Greg-R/qse2/README.md

QSE2DCEZ Transmitter Module

The documentation for this design is located here:
<https://kf5n.com/t41-2/qse2dcez/>
