Greg-R/qse2/doc/qse2.pdf

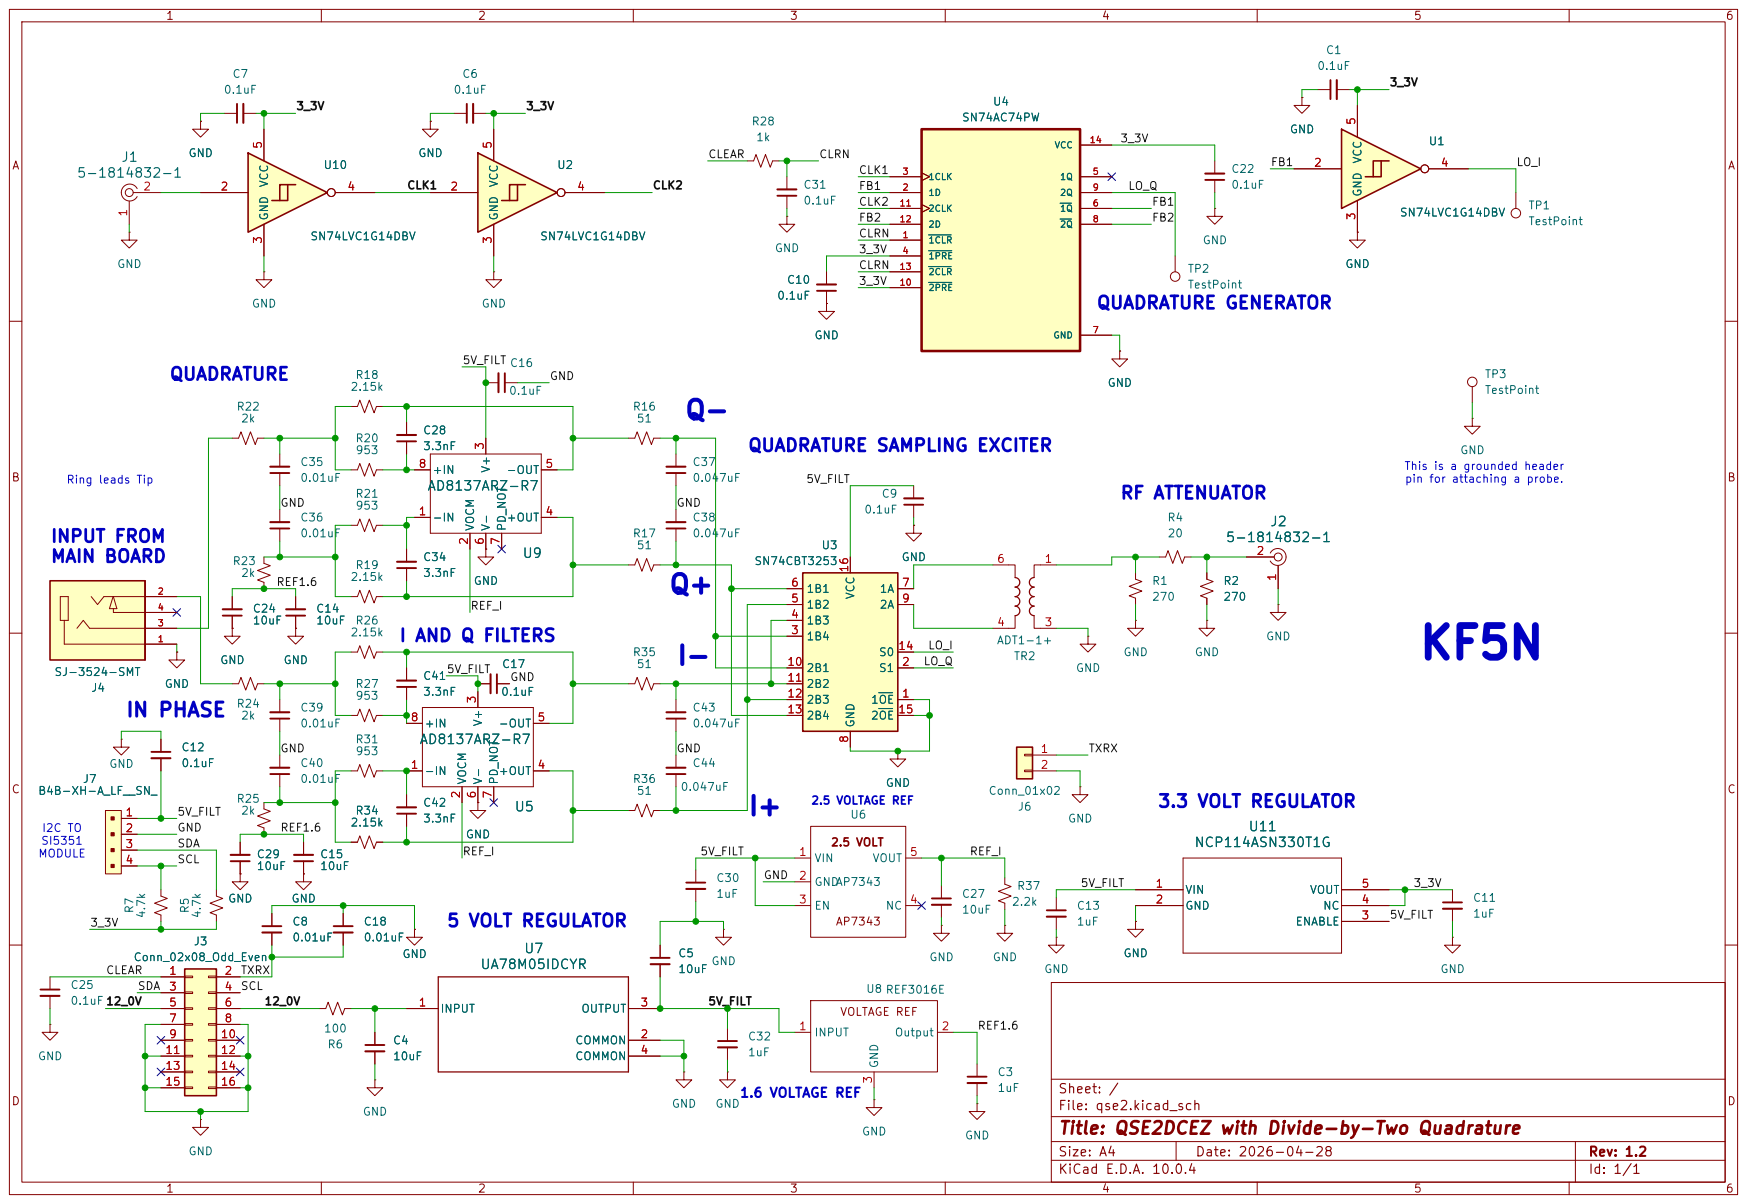
[picture p1: page 1]

This is a grounded header pin for attaching a probe.

2B1 10
2B2 11

Sheet: /
File: qse2.kicad_sch
Title: QSE2DCEZ with Divide-by-Two Quadrature

Size: A4 | Rev: 1.2
KiCad E.D.A. 10.0.4 | Id: 1/1
