Greg-R/qse2/qse2.kicad_pcb

## KiCad design qse2.kicad_pcb (2026-07-23)

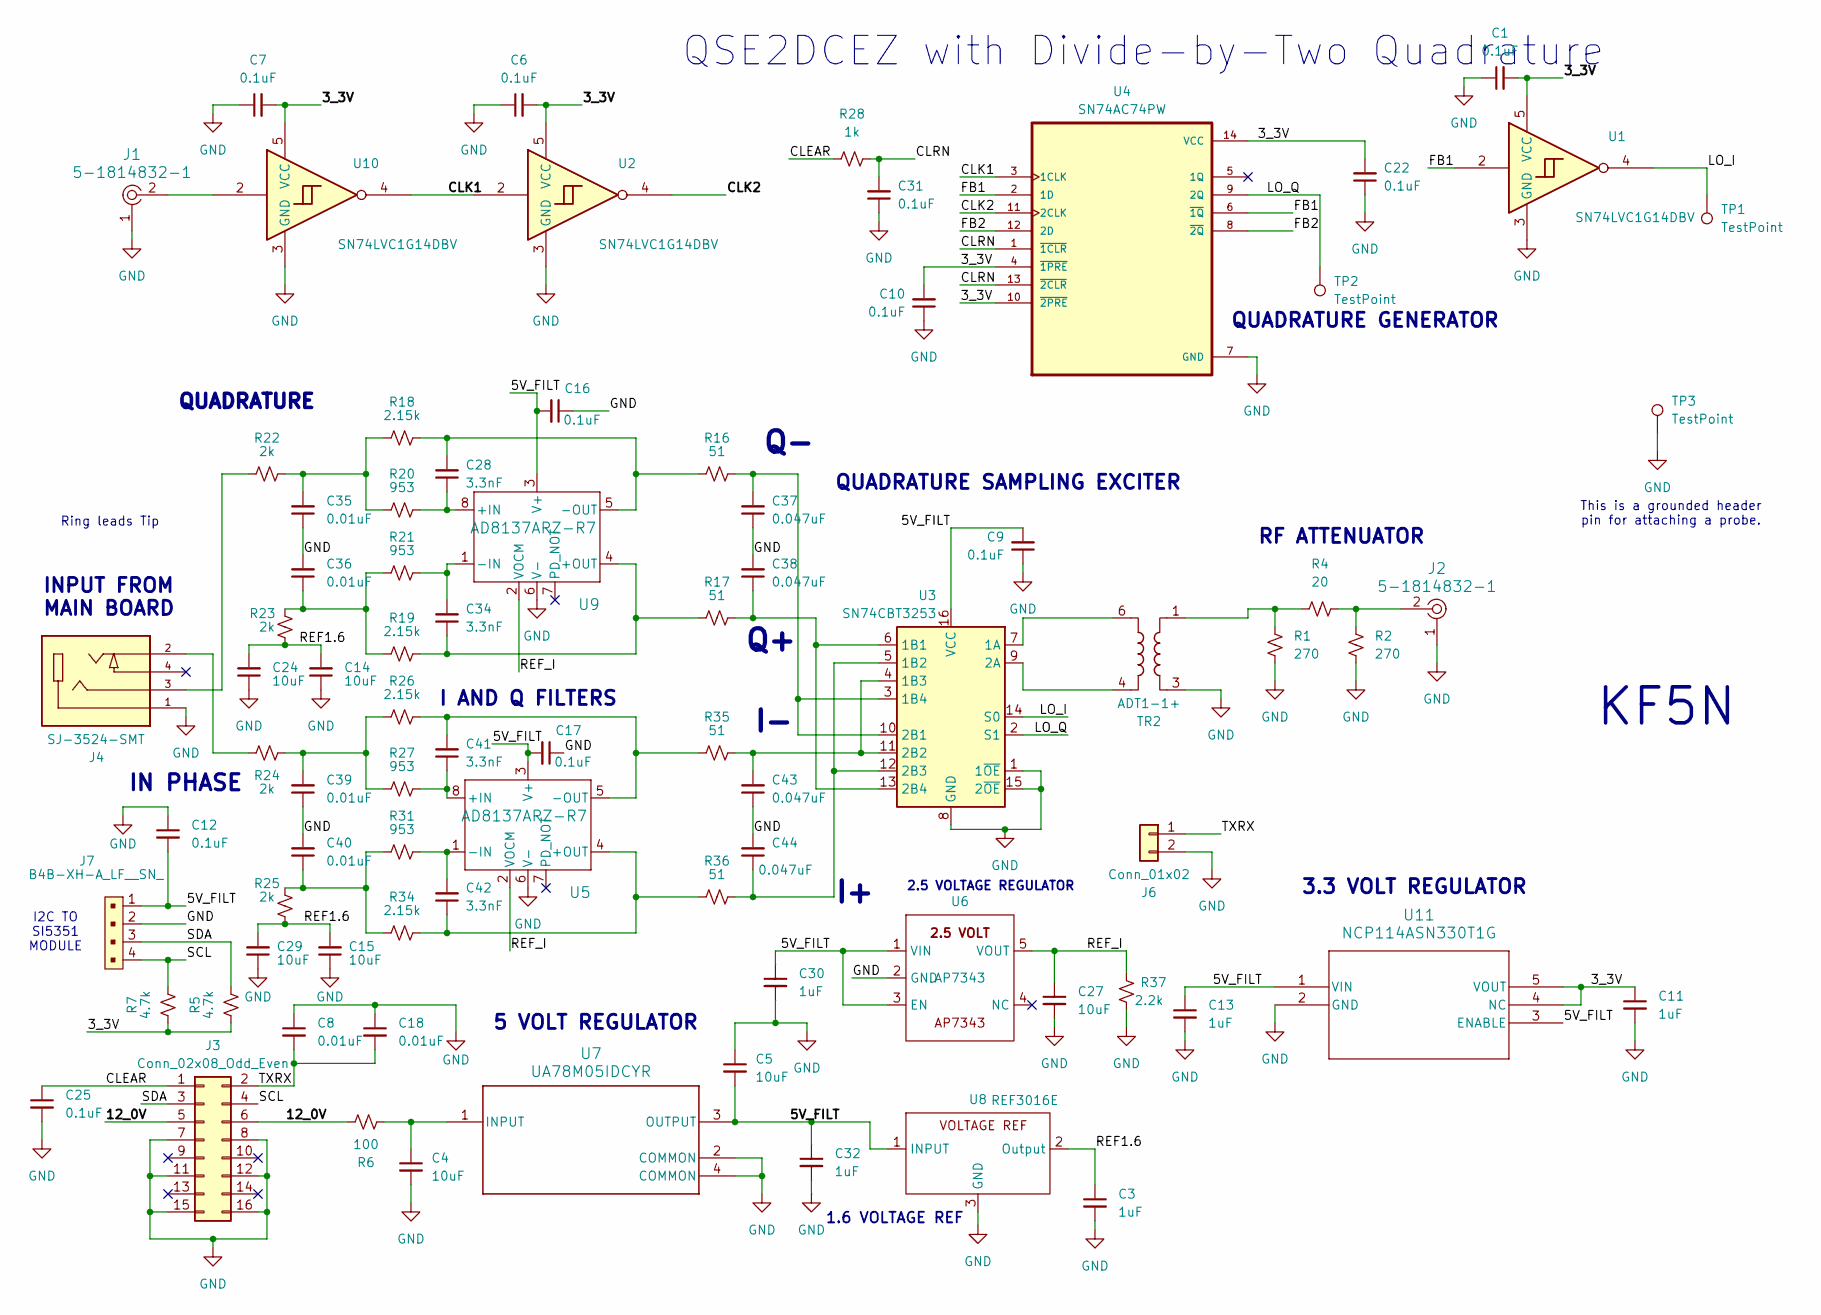
[picture p2: schematic qse2.kicad_sch, QSE2DCEZ with Divide-by-Two Quadrature]

Parts:
C1, C6, C7, C9, C10, C12, C16, C17, C22, C25, C31: 0.1uF; C_1206_3216Metric
C3, C11, C13, C30, C32: 1uF; C_1206_3216Metric
C4, C5, C14, C15, C24, C27, C29: 10uF; C_1206_3216Metric
C8, C18, C35, C36, C39, C40: 0.01uF; C_1206_3216Metric
C28, C34, C41, C42: 3.3nF; C_1206_3216Metric
C37, C38, C43, C44: 0.047uF; C_1206_3216Metric
J1, J2: 5-1814832-1; RF_SMA_Vertical_5-1814832-1; MPN 5-1814832-1; Digi-Key_PN A97594-ND
J3: Conn_02x08_Odd_Even; IDC-Header_2x08_P2.54mm_Vertical
J4: SJ-3524-SMT; CUI_SJ-3524-SMT; PARTREV 1.03
J6: Conn_01x02; PinHeader_1x2_P2.5mm_Drill1.1mm
J7: B4B-XH-A_LF__SN_; PinHeader_1x4_P2.5mm_Drill1.1mm; MPN B4B-XH-A(LF)(SN); Digi-Key_PN 455-2249-ND
R1, R2: 270; R_1206_3216Metric
R4: 20; R_1206_3216Metric
R5, R7: 4.7k; R_1206_3216Metric
R6: 100; R_1206_3216Metric
R16, R17, R35, R36: 51; R_1206_3216Metric
R18, R19, R26, R34: 2.15k; R_1206_3216Metric
R20, R21, R27, R31: 953; R_1206_3216Metric
R22, R23, R24, R25: 2k; R_1206_3216Metric
R28: 1k; R_1206_3216Metric
R37: 2.2k; R_1206_3216Metric
TP1, TP2: TestPoint; TestPoint_Pad_D1.0mm
TP3: TestPoint; PinHeader_1x01_P2.54mm_Vertical
TR2: ADT1-1+; Mini-Circuits_CD542_H2.84mm
U1, U2, U10: SN74LVC1G14DBV; SOT-23-5
U3: SN74CBT3253; SOIC-16_3.9x9.9mm_P1.27mm
U4: SN74AC74PW; SOIC-14_3.9x8.7mm_P1.27mm
U5, U9: AD8137ARZ-R7; R_8_ADI
U6: AP7343; TSOT-23-5
U7: UA78M05IDCYR; DCY0004A_N
U8: REF3016E; SOT-23-3
U11: NCP114ASN330T1G; TSOP-5-483-N_ONS

Connections:
/3_3V: C1.2, C6.2, C7.2, C10.2, C11.1, C22.2, R5.1, R7.1, U1.5 (VCC), U2.5 (VCC), U4.4 (~1PRE), U4.10 (~2PRE), U4.14 (VCC), U10.5 (VCC), U11.4 (NC), U11.5 (VOUT)
/5V_FILT: C5.2, C9.2, C12.2, C13.1, C16.2, C17.2, C30.1, C32.1, J7.1, U3.16 (VCC), U5.3 (V+), U6.1 (VIN), U6.3 (EN), U7.3 (OUTPUT), U8.1 (INPUT), U9.3 (V+), U11.1 (VIN), U11.3 (ENABLE)
/12_0V: J3.5, J3.6, R6.1
/CLEAR: C25.1, J3.1, R28.1
/CLK1: U2.2, U4.3 (1CLK), U10.4
/CLK2: U2.4, U4.11 (2CLK)
/CLRN: C31.2, R28.2, U4.1 (~1CLR), U4.13 (~2CLR)
/FB1: U1.2, U4.2 (1D), U4.6 (~1Q)
/FB2: U4.8 (~2Q), U4.12 (2D)
/LO_I: TP1.1 (1_1), U1.4, U3.14 (S0)
/LO_Q: TP2.1 (1_1), U3.2 (S1), U4.9 (2Q)
/REF1.6: C3.1, C14.2, C15.2, C24.2, C29.2, R23.1, R25.1, U8.2 (Output)
/REF_I: C27.1, R37.2, U5.2 (VOCM), U6.5 (VOUT), U9.2 (VOCM)
/SCL: J3.4, J7.4, R7.2
/SDA: J3.3, J7.3, R5.2
/TXRX: C8.2, C18.2, J3.2, J6.1
GND: C1.1, C3.2, C4.2, C5.1, C6.1, C7.1, C8.1, C9.1, C10.1, C11.2, C12.1, C13.2, C14.1, C15.1, C16.1, C17.1, C18.1, C22.1, C24.1, C25.2, C27.2, C29.1, C30.2, C31.1, C32.2, C35.1, C36.2, C37.1, C38.2, C39.1, C40.2, C43.1, C44.2, J1.1, J2.1, J3.7, J3.8, J3.11, J3.12, J3.15, J3.16, J4.1, J6.2, J7.2, R1.2, R2.2, R37.1, TP3.1 (1_1), TR2.3, U1.3 (GND), U2.3 (GND), U3.1 (1~OE), U3.8 (GND), U3.15 (2~OE), U4.7 (GND), U5.6 (V-), U6.2 (GND), U7.2 (COMMON), U7.4 (COMMON), U8.3 (GND), U9.6 (V-), U10.3 (GND), U11.2 (GND)
unnamed: C35.2, R18.1, R20.1, R22.2
unnamed: C36.1, R19.1, R21.1, R23.2
unnamed: C39.2, R24.2, R26.1, R27.1
unnamed: C40.1, R25.2, R31.1, R34.1
unnamed: J1.2, U10.2
unnamed: J2.2, R2.1, R4.2
unnamed: J4.2, R24.1
unnamed: J4.3, R22.1
unnamed: R1.1, R4.1, TR2.1
unnamed: TR2.6, U3.7 (1A)
unnamed: C38.1, R17.2, U3.6 (1B1), U3.13 (2B4)
unnamed: C44.1, R36.2, U3.5 (1B2), U3.12 (2B3)
unnamed: C43.2, R35.2, U3.4 (1B3), U3.11 (2B2)
unnamed: C37.2, R16.2, U3.3 (1B4), U3.10 (2B1)
unnamed: TR2.4, U3.9 (2A)
unnamed: C41.1, R27.2, U5.8 (+IN)
unnamed: C42.1, R34.2, R36.1, U5.4 (+OUT)
unnamed: C42.2, R31.2, U5.1 (-IN)
unnamed: C41.2, R26.2, R35.1, U5.5 (-OUT)
unnamed: C4.1, R6.2, U7.1 (INPUT)
unnamed: C28.1, R20.2, U9.8 (+IN)
unnamed: C34.1, R17.1, R19.2, U9.4 (+OUT)
unnamed: C34.2, R21.2, U9.1 (-IN)
unnamed: C28.2, R16.1, R18.2, U9.5 (-OUT)

Notes on the sheet:
Ring leads Tip
3.3 VOLT REGULATOR
KF5N
QUADRATURE
IN PHASE
QUADRATURE SAMPLING EXCITER
QUADRATURE GENERATOR
1.6 VOLTAGE REF
RF ATTENUATOR
I2C TO SI5351 MODULE
INPUT FROM MAIN BOARD
This is a grounded header pin for attaching a probe.
I AND Q FILTERS
5 VOLT REGULATOR
QSE2DCEZ with Divide-by-Two Quadrature
2.5 VOLTAGE REGULATOR

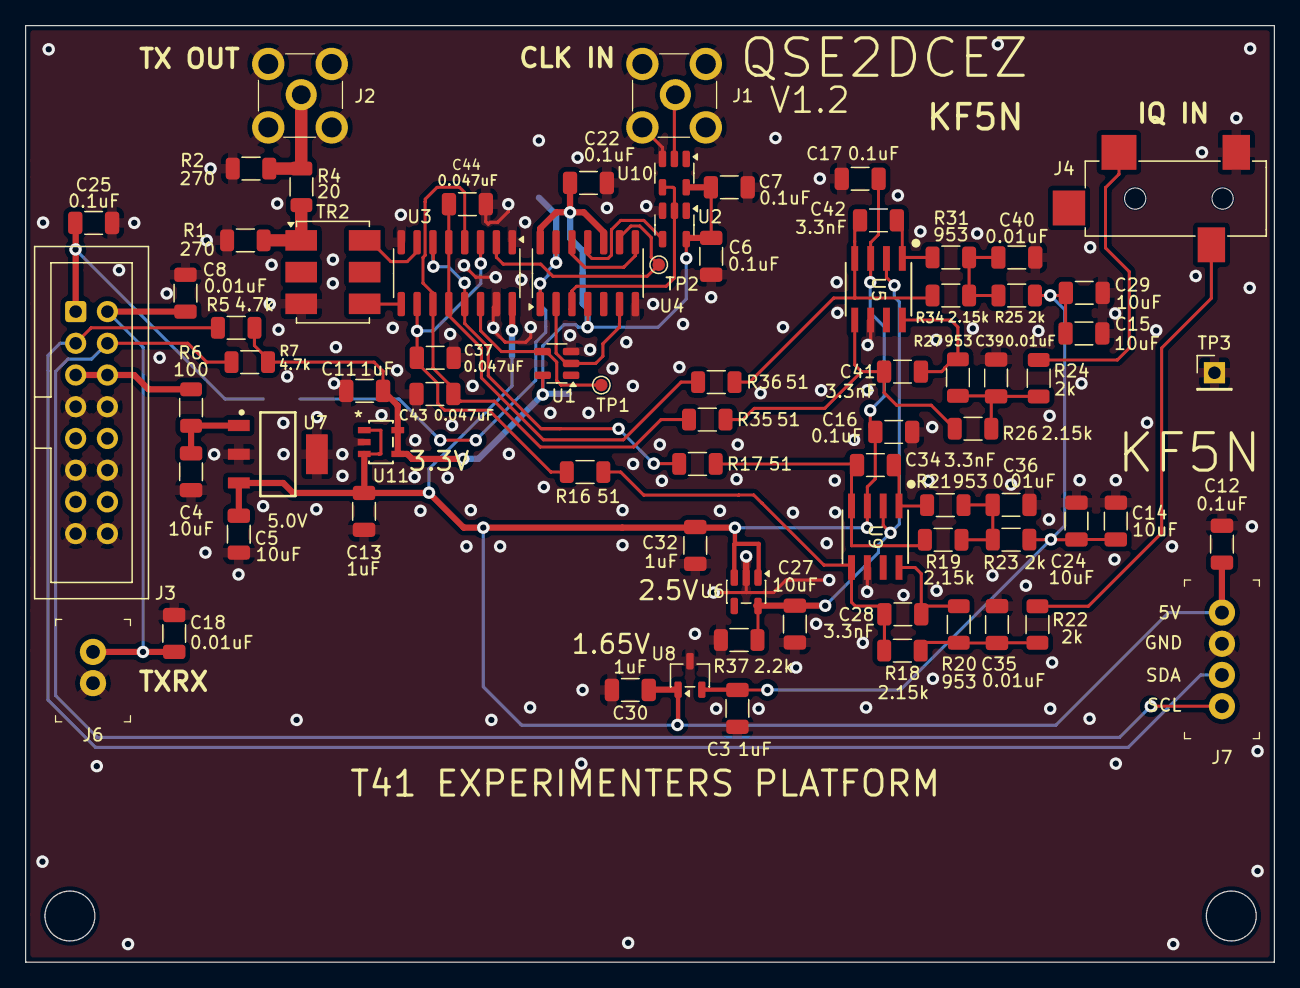
[picture p3: board qse2.kicad_pcb from above]

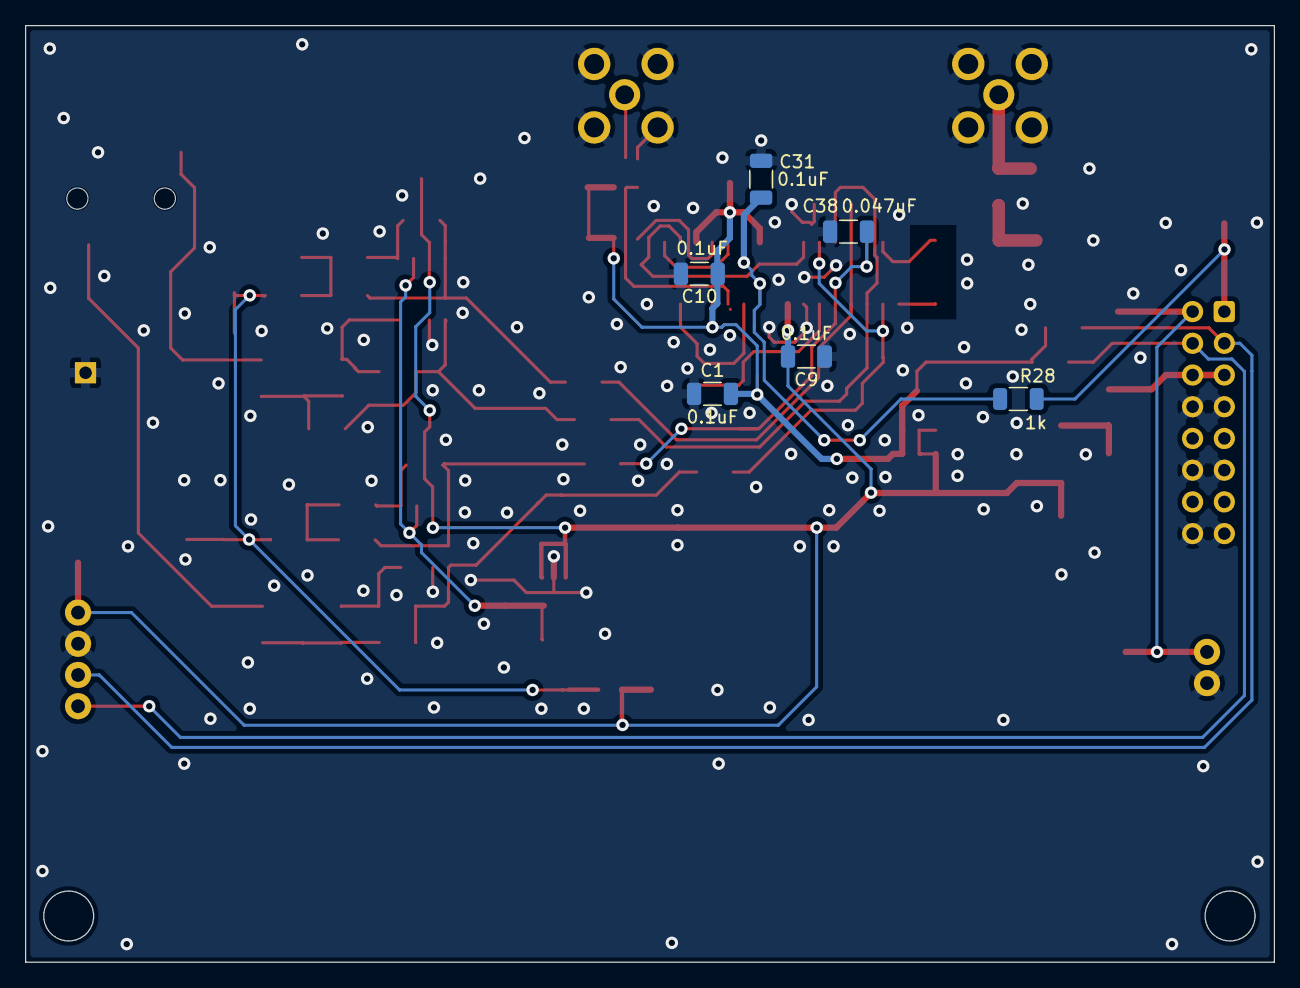
[picture p4: board qse2.kicad_pcb from below]

Board: 2 copper layers, 100.0 x 75.0 mm, 82 parts (6 on the bottom side), 41 nets.
