Greg-R/qse2/(commit log)

2024-03-05 Initial commit.
    [qse2-B_Cu.gbl, qse2-B_Mask.gbs, qse2-B_Silkscreen.gbo, qse2-Edge_Cuts.gm1, qse2-F_Cu.gtl, qse2-F_Mask.gts, qse2-F_Silkscreen.gto, qse2-NPTH.drl]
2024-03-05 Cleaned up gerbers.
    [qse2-B_Cu.gbl, qse2-B_Mask.gbs, qse2-B_Silkscreen.gbo, qse2-Edge_Cuts.gm1, qse2-F_Cu.gtl, qse2-F_Mask.gts, qse2-F_Silkscreen.gto, qse2-NPTH.drl]
2024-03-05 Updated schematic PDF.
2024-03-14 Minor change to schematic text.
    [qse2.kicad_sch]
2024-03-16 Added description of Audio Adapter changes to README.md.
    [qse2.kicad_pcb]
2024-03-16 Updated README with comment about old QSE boards still working with revised Audio Adapter.
2024-03-28 Minor update to front silkscreen.
    [qse2-B_Cu.gbl, qse2-B_Mask.gbs, qse2-B_Silkscreen.gbo, qse2-Edge_Cuts.gm1, qse2-F_Cu.gtl, qse2-F_Mask.gts, qse2-F_Silkscreen.gto, qse2-NPTH.drl]
2024-06-17 Minor revision of Gerbers.
2024-06-17 Announcement of revision in progress.
    [qse2-B_Cu.gbl, qse2-B_Mask.gbs, qse2-B_Silkscreen.gbo, qse2-Edge_Cuts.gm1, qse2-F_Cu.gtl, qse2-F_Mask.gts, qse2-F_Silkscreen.gto, qse2-NPTH.drl]
2024-06-26 Final gerbers before June release to PCB.
    [qse2-B_Cu.gbl, qse2-B_Mask.gbs, qse2-B_Silkscreen.gbo, qse2-Edge_Cuts.gm1, qse2-F_Cu.gtl, qse2-F_Mask.gts, qse2-F_Silkscreen.gto, qse2-NPTH.drl]
2024-06-29 Mostly cleaned up version with SOICs replacing TSOPs.
    [qse2-B_Cu.gbl, qse2-B_Mask.gbs, qse2-B_Silkscreen.gbo, qse2-Edge_Cuts.gm1, qse2-F_Cu.gtl, qse2-F_Mask.gts, qse2-F_Silkscreen.gto, qse2-NPTH.drl]
2024-07-01 Ready to release V1.1 June 30.
    [qse2-B_Cu.gbl, qse2-B_Mask.gbs, qse2-B_Silkscreen.gbo, qse2-Edge_Cuts.gm1, qse2-F_Cu.gtl, qse2-F_Mask.gts, qse2-F_Silkscreen.gto, qse2-NPTH.drl]
2024-07-26 Updated README and very minor update to Gerbers.
    [qse2-B_Cu.gbl, qse2-B_Mask.gbs, qse2-B_Silkscreen.gbo, qse2-Edge_Cuts.gm1, qse2-F_Cu.gtl, qse2-F_Mask.gts, qse2-F_Silkscreen.gto, qse2-NPTH.drl]
2024-07-27 Added notes to schematic.
    [qse2.kicad_sch]
2024-08-19 Fixed regulator part numbers on schematic.
    [qse2.kicad_sch]
2024-10-14 Release to fab.
    [qse2.kicad_sch]
2026-03-11 Clean up and update to new version Kicad.
    [qse2.kicad_pcb, qse2.kicad_sch]
2026-05-20 Swapped SDA and SCL to correct pins.
    [qse2.kicad_pcb, qse2.kicad_sch]
2026-07-11 Work in progress. Changing reference sources due to supply chain issue.
    [qse2.kicad_sch]
2026-07-13 Ready for release to fab.
    [qse2-B_Cu.gbl, qse2-B_Mask.gbs, qse2-B_Silkscreen.gbo, qse2-Edge_Cuts.gm1, qse2-F_Cu.gtl, qse2-F_Mask.gts, qse2-F_Silkscreen.gto, qse2-NPTH.drl]
2026-07-23 Changed text on schematic, very minor change.
    [qse2.kicad_sch]
2026-07-23 Updated page dates.
    [qse2.kicad_pcb, qse2.kicad_sch]
